Moldudley/Maslow-Mini-Control-Board/Merged Control Board/Maslow Mini Merged Board.kicad_pcb

## KiCad design Merged Control Board/Maslow Mini Merged Board.kicad_pcb (2026-09-01)

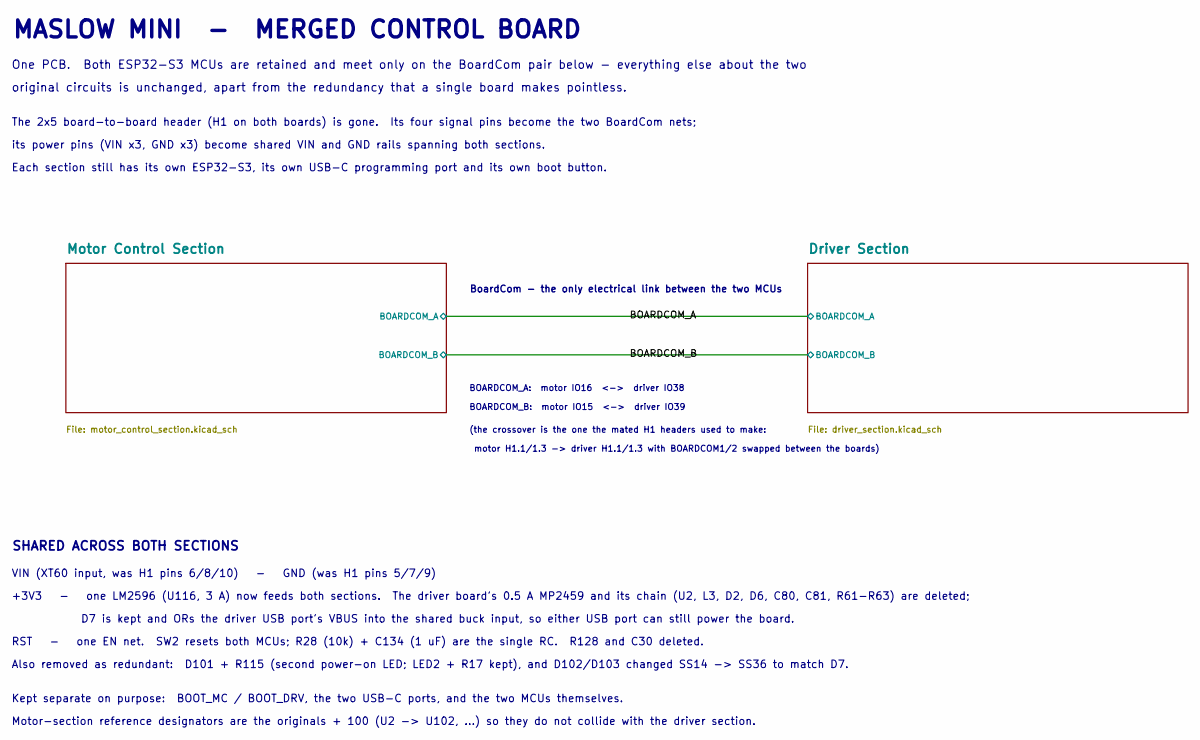
[picture p1: schematic Maslow Mini Merged Board.kicad_sch, Maslow Mini Merged Control Board]

Notes on the sheet:
MASLOW MINI - MERGED CONTROL BOARD
One PCB. Both ESP32-S3 MCUs are retained and meet only on the BoardCom pair below - everything else about the two
original circuits is unchanged, apart from the redundancy that a single board makes pointless.
The 2x5 board-to-board header (H1 on both boards) is gone. Its four signal pins become the two BoardCom nets;
its power pins (VIN x3, GND x3) become shared VIN and GND rails spanning both sections.
Each section still has its own ESP32-S3, its own USB-C programming port and its own boot button.
BoardCom - the only electrical link between the two MCUs
BOARDCOM_A: motor IO16 <-> driver IO38
BOARDCOM_B: motor IO15 <-> driver IO39
(the crossover is the one the mated H1 headers used to make:
motor H1.1/1.3 -> driver H1.1/1.3 with BOARDCOM1/2 swapped between the boards)
SHARED ACROSS BOTH SECTIONS
VIN (XT60 input, was H1 pins 6/8/10) - GND (was H1 pins 5/7/9)
+3V3 - one LM2596 (U116, 3 A) now feeds both sections. The driver board's 0.5 A MP2459 and its chain (U2, L3, D2, D6, C80, C81, R61-R63) are deleted;
D7 is kept and ORs the driver USB port's VBUS into the shared buck input, so either USB port can still power the board.
RST - one EN net. SW2 resets both MCUs; R28 (10k) + C134 (1 uF) are the single RC. R128 and C30 deleted.
Also removed as redundant: D101 + R115 (second power-on LED; LED2 + R17 kept), and D102/D103 changed SS14 -> SS36 to match D7.
Kept separate on purpose: BOOT_MC / BOOT_DRV, the two USB-C ports, and the two MCUs themselves.
Motor-section reference designators are the originals + 100 (U2 -> U102, ...) so they do not collide with the driver section.

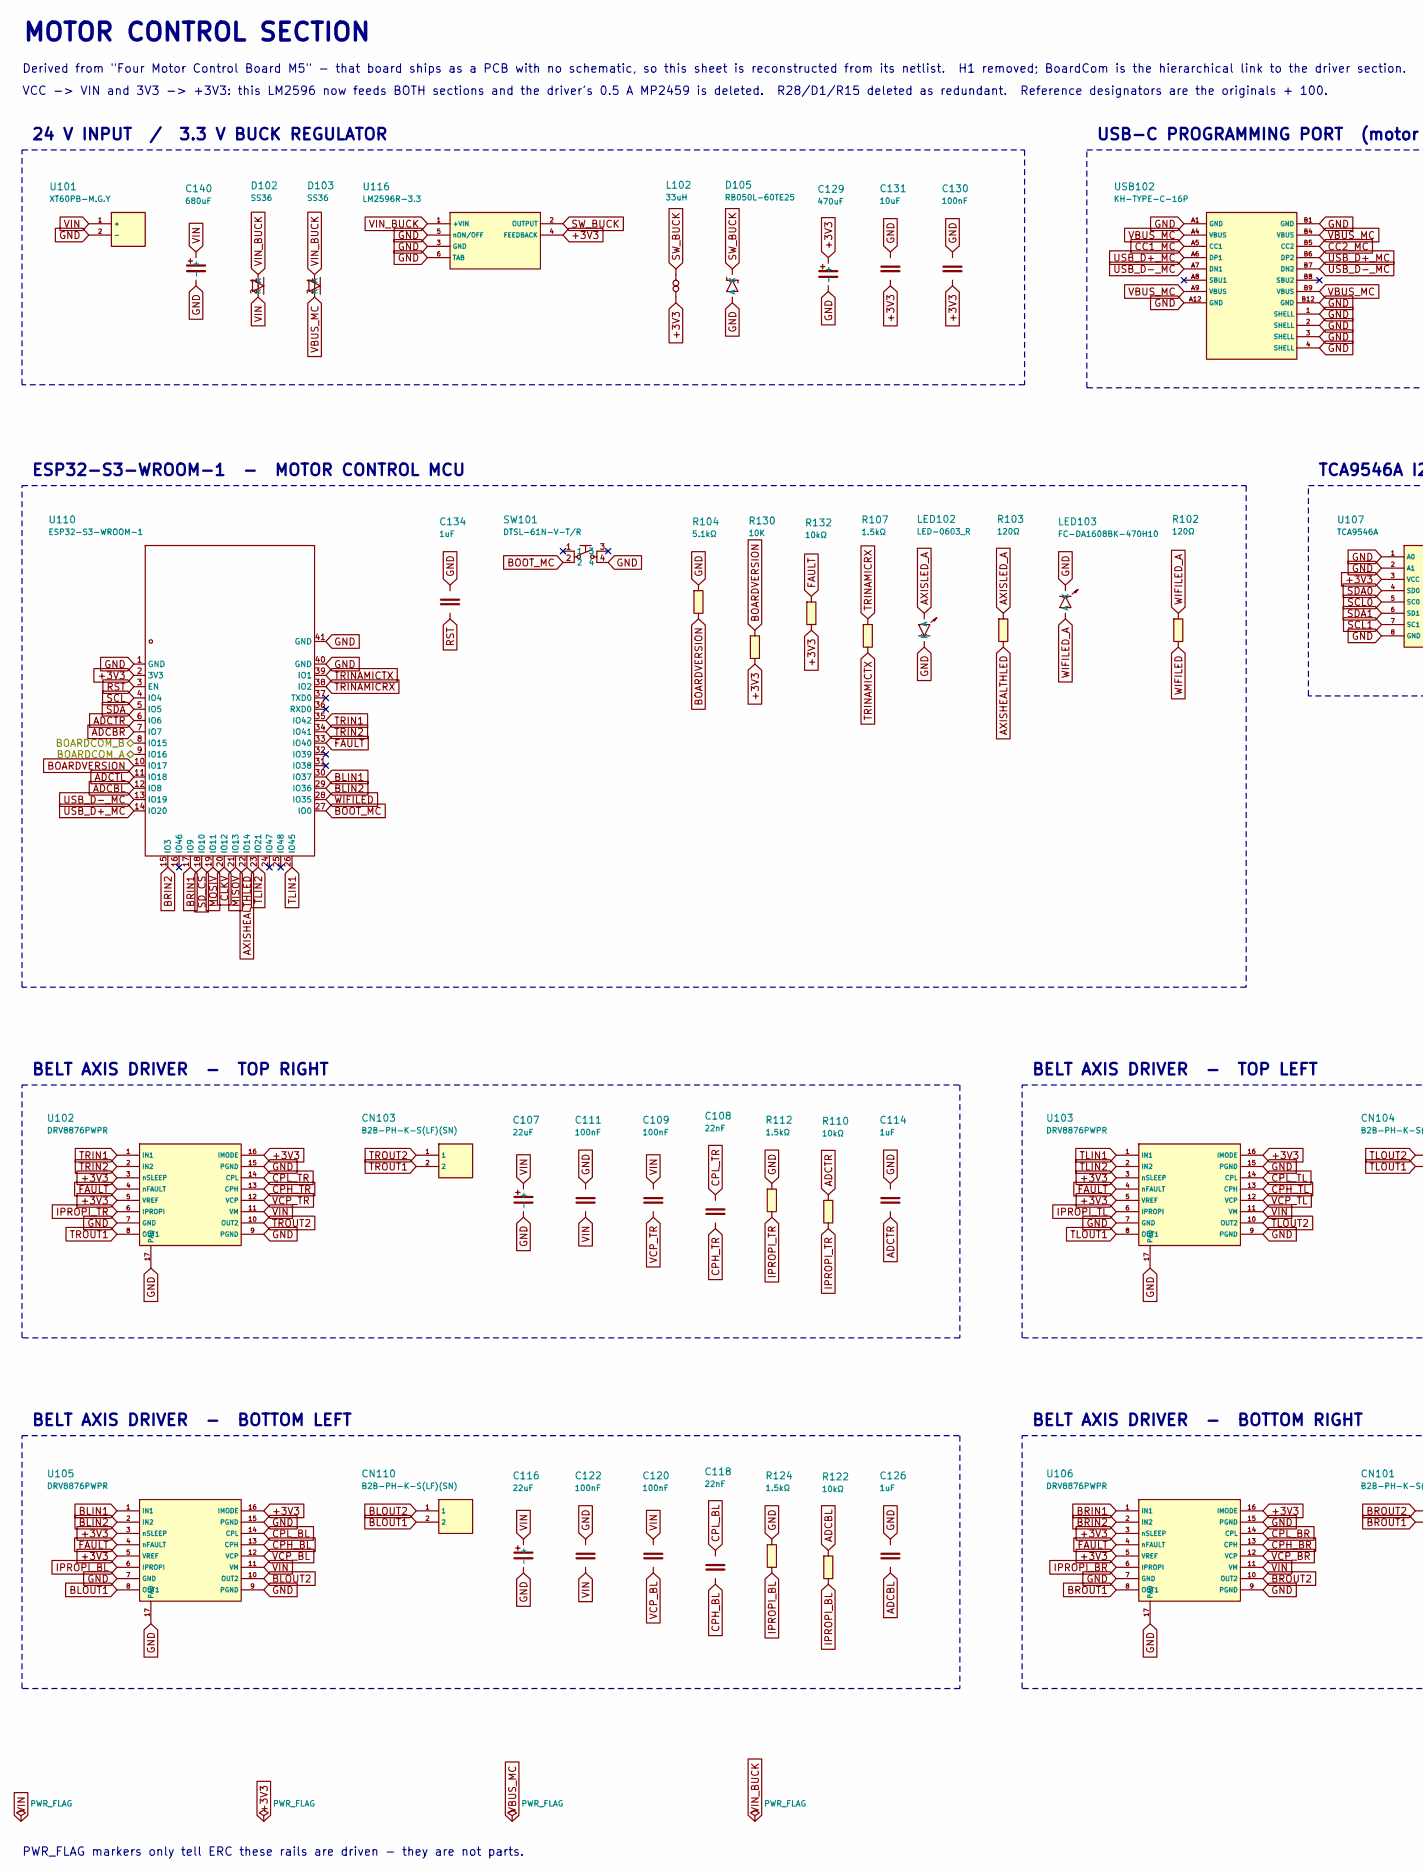
[picture p2: schematic motor_control_section.kicad_sch, part in row 1, column 1]

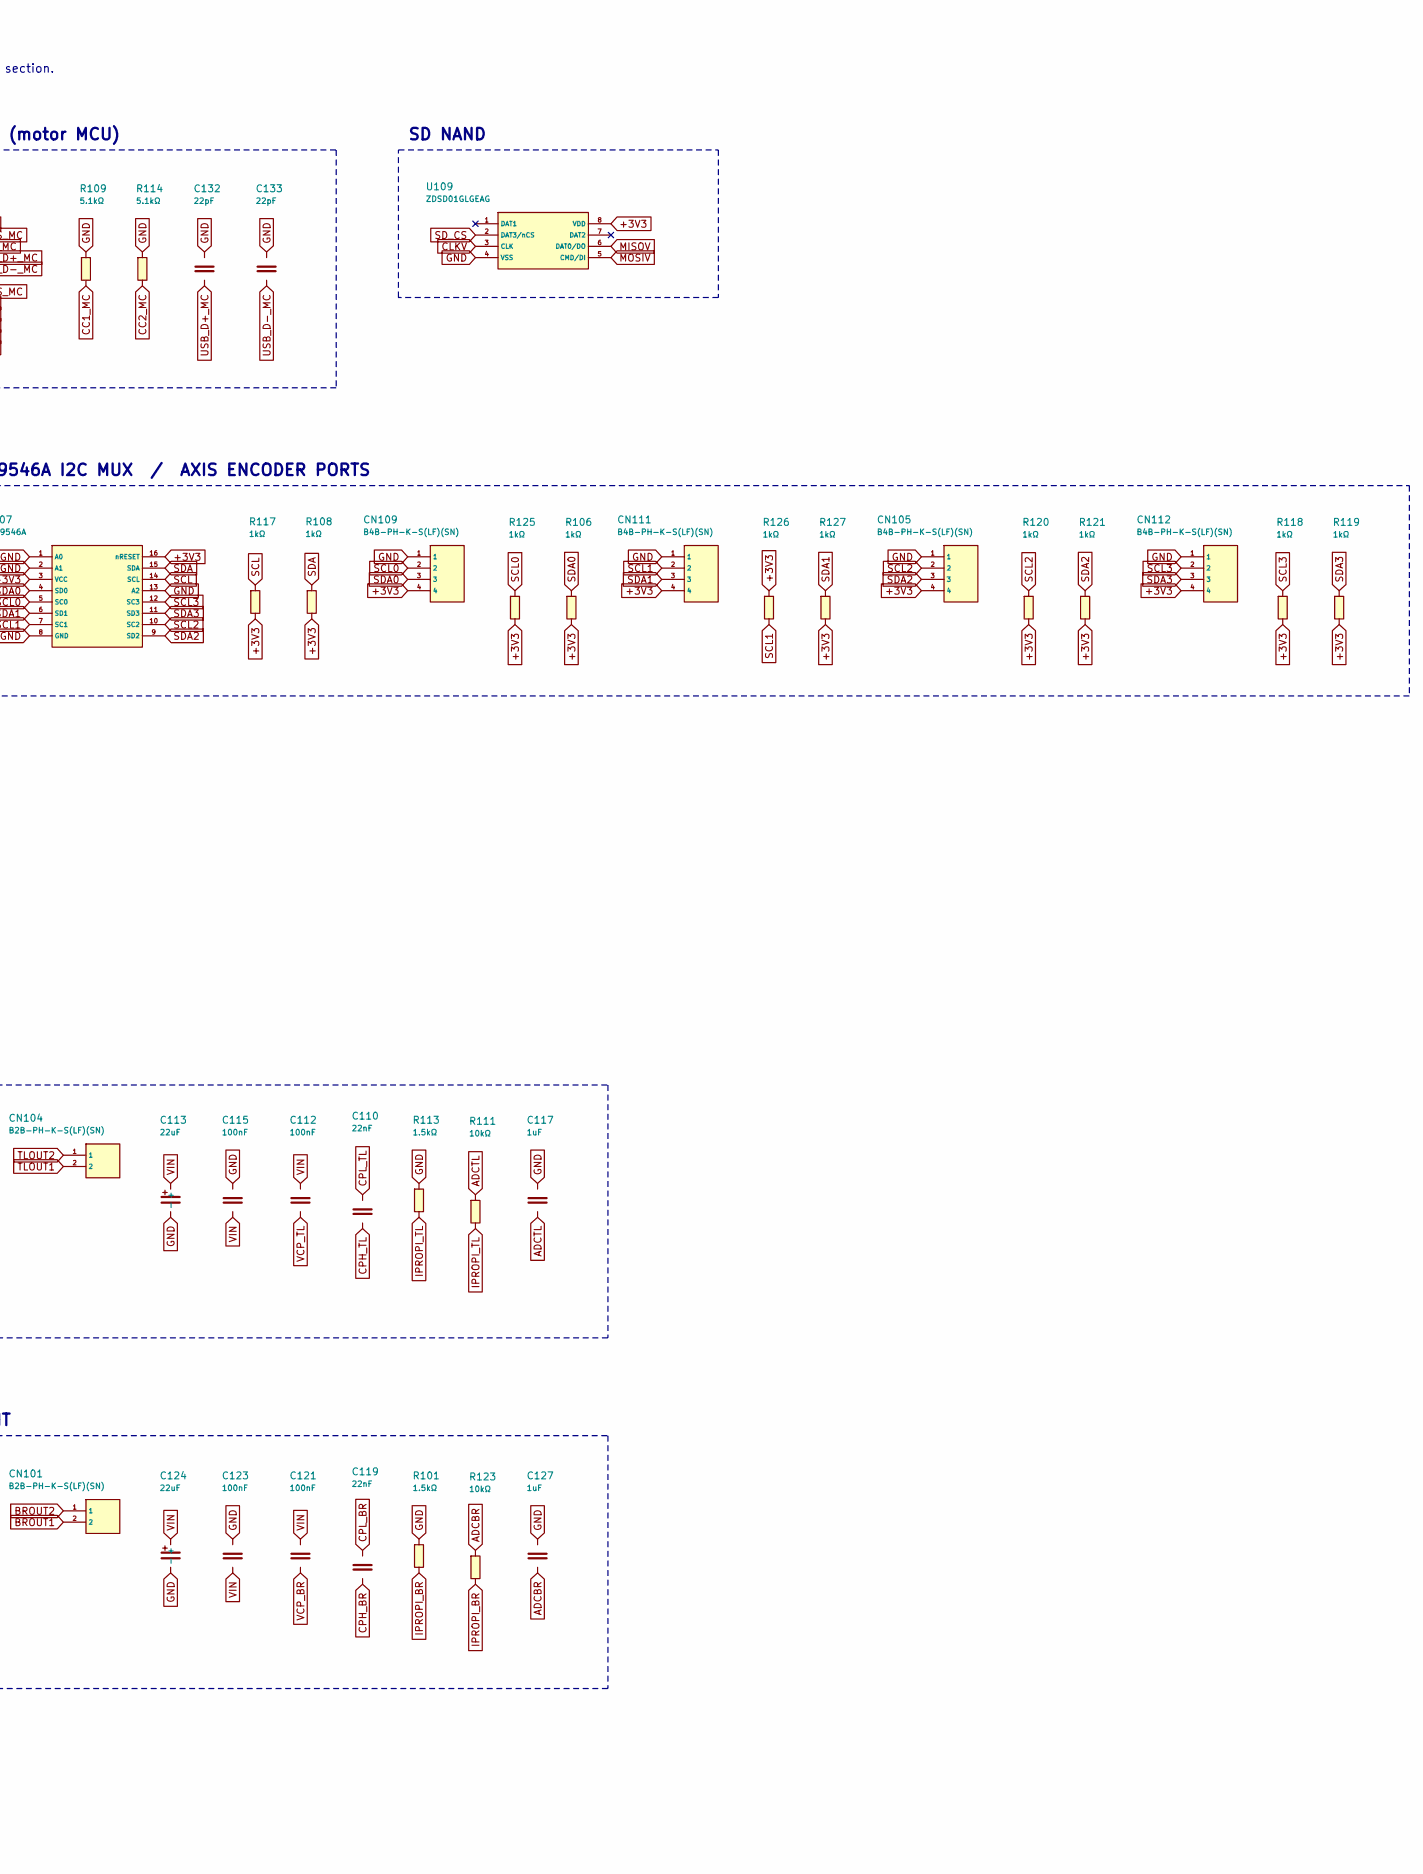
[picture p3: schematic motor_control_section.kicad_sch, part in row 1, column 2]

Parts:
C107, C113, C116, C124: 22uF; CAP-SMD_BD6.3-L6.6-W6.6-LS7.3-FD
C108, C110, C118, C119: 22nF; C0805
C109, C111, C112, C115, C120, C121, C122, C123: 100nF; C0805
C114, C117, C126, C127: 1uF; C0805
C129: 470uF; CAP-SMD_BD6.3-L6.6-W6.6-LS7.6-RD
C130: 100nF; C0603
C131: 10uF; C0805
C132, C133: 22pF; C0603
C134: 1uF; C0603
C140: 680uF; CAP-SMD_BD10.0-L10.3-W10.3-LS10.9-FD
CN101, CN103, CN104, CN110: B2B-PH-K-S(LF)(SN); CONN-TH_B2B-PH-K-S
CN105, CN109, CN111, CN112: B4B-PH-K-S(LF)(SN); CONN-TH_B4B-PH-K-S
D102, D103: SS36; D_SMA
D105: RB050L-60TE25; SMA_L4.3-W2.7-LS5.1-RD
L102: 33uH; IND-SMD_L6.0-W6.0
LED102: LED-0603_R; LED0603_RED
LED103: FC-DA1608BK-470H10; LED0603-RD
R101, R107, R112, R113, R124: 1.5kΩ; R0805
R102, R103: 120Ω; R0603
R104, R109, R114: 5.1kΩ; R0805
R106, R108, R117, R118, R119, R120, R121, R125, R126, R127: 1kΩ; R0402
R110, R111, R122, R123, R132: 10kΩ; R0805
R130: 10K; R0603
SW101: DTSL-61N-V-T/R; SW-SMD_4P-L6.2-W6.4-P4.00-LS7.2
U101: XT60PB-M.G.Y; CONN-TH_XT60PB-M
U102, U103, U105, U106: DRV8876PWPR; HTSSOP-16_L5.0-W4.4-P0.65-LS6.4-BL-EP
U107: TCA9546A; SOP-16_L5.0-W4.4-P0.65-LS6.4-BL
U109: ZDSD01GLGEAG; LGA-8_L6.0-W8.0-P1.27-BL
U110: ESP32-S3-WROOM-1; WIRELM-SMD_ESP32-S3-WROOM-1
U116: LM2596R-3.3; TO-263-5_L10.2-W8.6-P1.70-LS14.4-TL
USB102: KH-TYPE-C-16P; USB-C-SMD_KH-TYPE-C-16P

Connections:
+3V3: C129.1 (+), C130.2, C131.2, CN105.4, CN109.4, CN111.4, CN112.4, L102.2, R106.2, R108.2, R117.2, R118.2, R119.2, R120.2, R121.2, R125.2, R126.1, R127.2, R130.2, R132.2, U102.3 (nSLEEP), U102.5 (VREF), U102.16 (IMODE), U103.3 (nSLEEP), U103.5 (VREF), U103.16 (IMODE), U105.3 (nSLEEP), U105.5 (VREF), U105.16 (IMODE), U106.3 (nSLEEP), U106.5 (VREF), U106.16 (IMODE), U107.3 (VCC), U107.16 (nRESET), U109.8 (VDD), U110.2 (3V3), U116.4 (FEEDBACK); also elsewhere on the board
/BOARDCOM_A: U110.9 (IO16); also elsewhere on the board
/BOARDCOM_B: U110.8 (IO15); also elsewhere on the board
ADCBL: C126.2, R122.1, U110.12 (IO8)
ADCBR: C127.2, R123.1, U110.7 (IO7)
ADCTL: C117.2, R111.1, U110.11 (IO18)
ADCTR: C114.2, R110.1, U110.6 (IO6)
AXISHEALTHLED: R103.2, U110.22 (IO14)
AXISLED_A: LED102.1 (A), R103.1
BLIN1: U105.1 (IN1), U110.30 (IO37)
BLIN2: U105.2 (IN2), U110.29 (IO36)
BLOUT1: CN110.2, U105.8 (OUT1)
BLOUT2: CN110.1, U105.10 (OUT2)
BOARDVERSION: R104.2, R130.1, U110.10 (IO17)
BOOT_MC: SW101.2, U110.27 (IO0)
BRIN1: U106.1 (IN1), U110.17 (IO9)
BRIN2: U106.2 (IN2), U110.15 (IO3)
BROUT1: CN101.2, U106.8 (OUT1)
BROUT2: CN101.1, U106.10 (OUT2)
CC1_MC: R109.2, USB102.A5 (CC1)
CC2_MC: R114.2, USB102.B5 (CC2)
CLKV: U109.3 (CLK), U110.20 (IO12)
CPH_BL: C118.2, U105.13 (CPH)
CPH_BR: C119.2, U106.13 (CPH)
CPH_TL: C110.2, U103.13 (CPH)
CPH_TR: C108.2, U102.13 (CPH)
CPL_BL: C118.1, U105.14 (CPL)
CPL_BR: C119.1, U106.14 (CPL)
CPL_TL: C110.1, U103.14 (CPL)
CPL_TR: C108.1, U102.14 (CPL)
FAULT: R132.1, U102.4 (nFAULT), U103.4 (nFAULT), U105.4 (nFAULT), U106.4 (nFAULT), U110.33 (IO40)
GND: C107.2 (-), C111.1, C113.2 (-), C114.1, C115.1, C116.2 (-), C117.1, C122.1, C123.1, C124.2 (-), C126.1, C127.1, C129.2 (-), C130.1, C131.1, C132.1, C133.1, C134.1, C140.2 (-), CN105.1, CN109.1, CN111.1, CN112.1, D105.2 (A), LED102.2 (K), LED103.1 (K), R101.1, R104.1, R109.1, R112.1, R113.1, R114.1, R124.1, SW101.4, U101.2 (-), U102.7 (GND), U102.9 (PGND), U102.15 (PGND), U102.17 (PAD), U103.7 (GND), U103.9 (PGND), U103.15 (PGND), U103.17 (PAD), U105.7 (GND), U105.9 (PGND), U105.15 (PGND), U105.17 (PAD), U106.7 (GND), U106.9 (PGND), U106.15 (PGND), U106.17 (PAD), U107.1 (A0), U107.2 (A1), U107.8 (GND), U107.13 (A2), U109.4 (VSS), U110.1 (GND), U110.40 (GND), U110.41 (GND), U116.3 (GND), U116.5 (nON/OFF), U116.6 (TAB), USB102.1 (SHELL), USB102.2 (SHELL), USB102.3 (SHELL), USB102.4 (SHELL), USB102.A1 (GND), USB102.A12 (GND), USB102.B1 (GND), USB102.B12 (GND); also elsewhere on the board
IPROPI_BL: R122.2, R124.2, U105.6 (IPROPI)
IPROPI_BR: R101.2, R123.2, U106.6 (IPROPI)
IPROPI_TL: R111.2, R113.2, U103.6 (IPROPI)
IPROPI_TR: R110.2, R112.2, U102.6 (IPROPI)
MISOV: U109.6 (DAT0/DO), U110.21 (IO13)
MOSIV: U109.5 (CMD/DI), U110.19 (IO11)
RST: C134.2, U110.3 (EN); also elsewhere on the board
SCL: R117.1, U107.14 (SCL), U110.4 (IO4)
SCL0: CN109.2, R125.1, U107.5 (SC0)
SCL1: CN111.2, R126.2, U107.7 (SC1)
SCL2: CN105.2, R120.1, U107.10 (SC2)
SCL3: CN112.2, R118.1, U107.12 (SC3)
SDA: R108.1, U107.15 (SDA), U110.5 (IO5)
SDA0: CN109.3, R106.1, U107.4 (SD0)
SDA1: CN111.3, R127.1, U107.6 (SD1)
SDA2: CN105.3, R121.1, U107.9 (SD2)
SDA3: CN112.3, R119.1, U107.11 (SD3)
SD_CS: U109.2 (DAT3/nCS), U110.18 (IO10)
SW_BUCK: D105.1 (K), L102.1, U116.2 (OUTPUT)
TLIN1: U103.1 (IN1), U110.26 (IO45)
TLIN2: U103.2 (IN2), U110.23 (IO21)
TLOUT1: CN104.2, U103.8 (OUT1)
TLOUT2: CN104.1, U103.10 (OUT2)
TRIN1: U102.1 (IN1), U110.35 (IO42)
TRIN2: U102.2 (IN2), U110.34 (IO41)
TRINAMICRX: R107.1, U110.38 (IO2)
TRINAMICTX: R107.2, U110.39 (IO1)
TROUT1: CN103.2, U102.8 (OUT1)
TROUT2: CN103.1, U102.10 (OUT2)
USB_D+_MC: C132.2, U110.14 (IO20), USB102.A6 (DP1), USB102.B6 (DP2)
USB_D-_MC: C133.2, U110.13 (IO19), USB102.A7 (DN1), USB102.B7 (DN2)
VBUS_MC: D103.2 (A), USB102.A4 (VBUS), USB102.A9 (VBUS), USB102.B4 (VBUS), USB102.B9 (VBUS)
VCP_BL: C120.2, U105.12 (VCP)
VCP_BR: C121.2, U106.12 (VCP)
VCP_TL: C112.2, U103.12 (VCP)
VCP_TR: C109.2, U102.12 (VCP)
VIN: C107.1 (+), C109.1, C111.2, C112.1, C113.1 (+), C115.2, C116.1 (+), C120.1, C121.1, C122.2, C123.2, C124.1 (+), C140.1 (+), D102.2 (A), U101.1 (+), U102.11 (VM), U103.11 (VM), U105.11 (VM), U106.11 (VM); also elsewhere on the board
VIN_BUCK: D102.1 (K), D103.1 (K), U116.1 (+VIN); also elsewhere on the board
WIFILED: R102.2, U110.28 (IO35)
WIFILED_A: LED103.2 (A), R102.1

Notes on the sheet:
MOTOR CONTROL SECTION
Derived from "Four Motor Control Board M5" - that board ships as a PCB with no schematic, so this sheet is reconstructed from its netlist. H1 removed; BoardCom is the hierarchical link to the driver section.
VCC -> VIN and 3V3 -> +3V3: this LM2596 now feeds BOTH sections and the driver's 0.5 A MP2459 is deleted. R28/D1/R15 deleted as redundant. Reference designators are the originals + 100.
24 V INPUT / 3.3 V BUCK REGULATOR
USB-C PROGRAMMING PORT (motor MCU)
SD NAND
ESP32-S3-WROOM-1 - MOTOR CONTROL MCU
TCA9546A I2C MUX / AXIS ENCODER PORTS
BELT AXIS DRIVER - TOP RIGHT
BELT AXIS DRIVER - TOP LEFT
BELT AXIS DRIVER - BOTTOM LEFT
BELT AXIS DRIVER - BOTTOM RIGHT
PWR_FLAG markers only tell ERC these rails are driven - they are not parts.

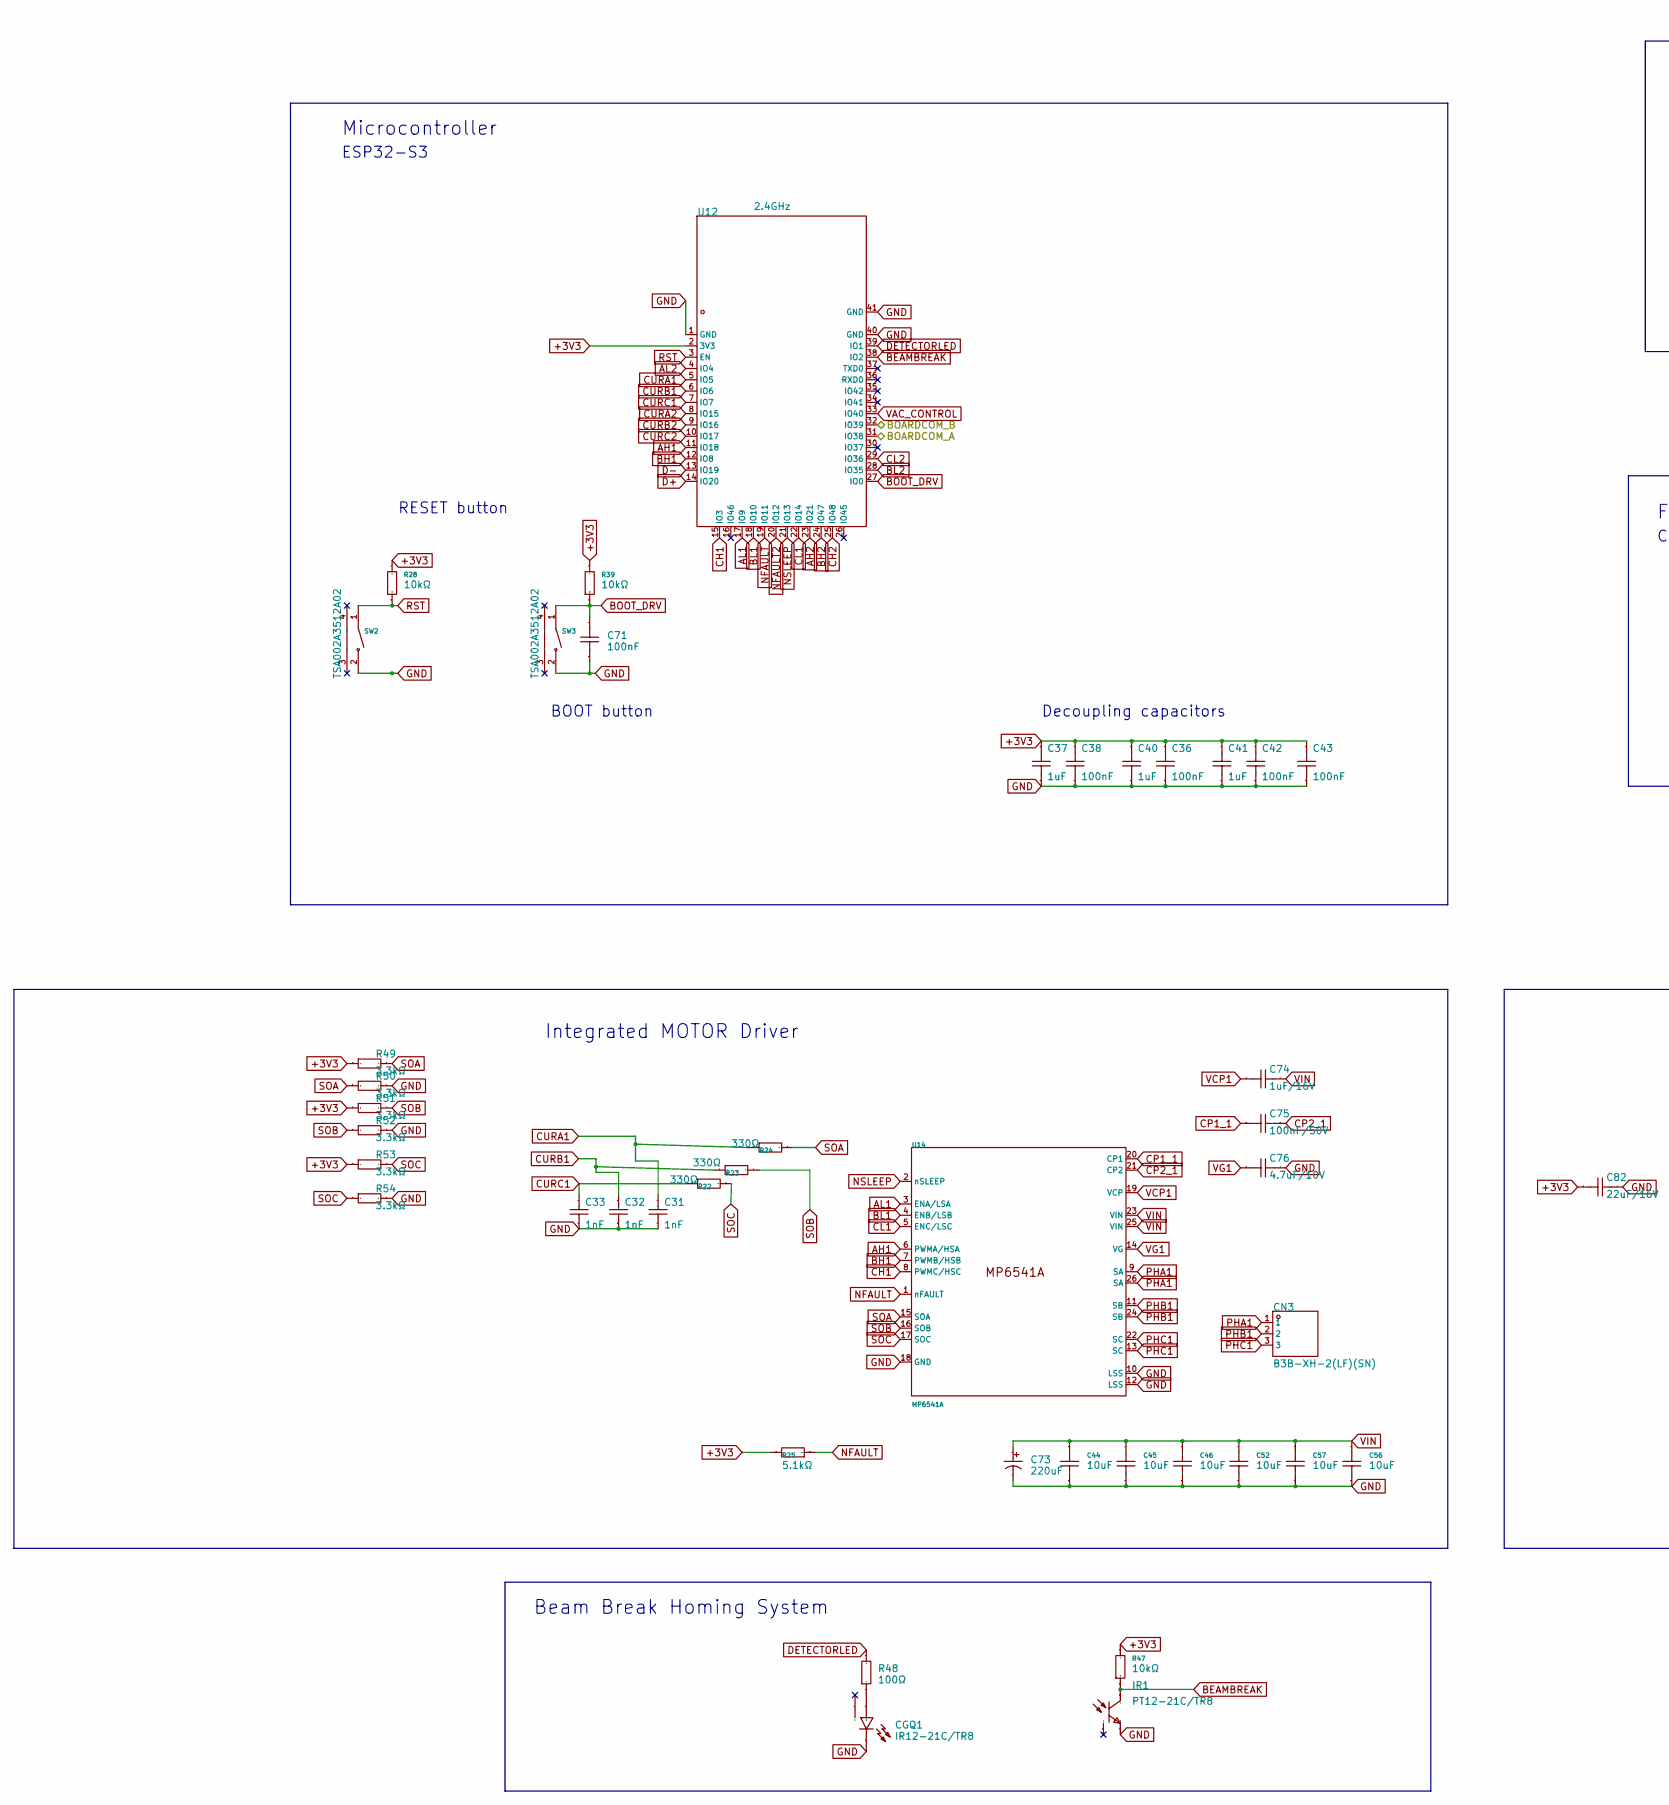
[picture p4: schematic driver_section.kicad_sch, part in row 1, column 1]

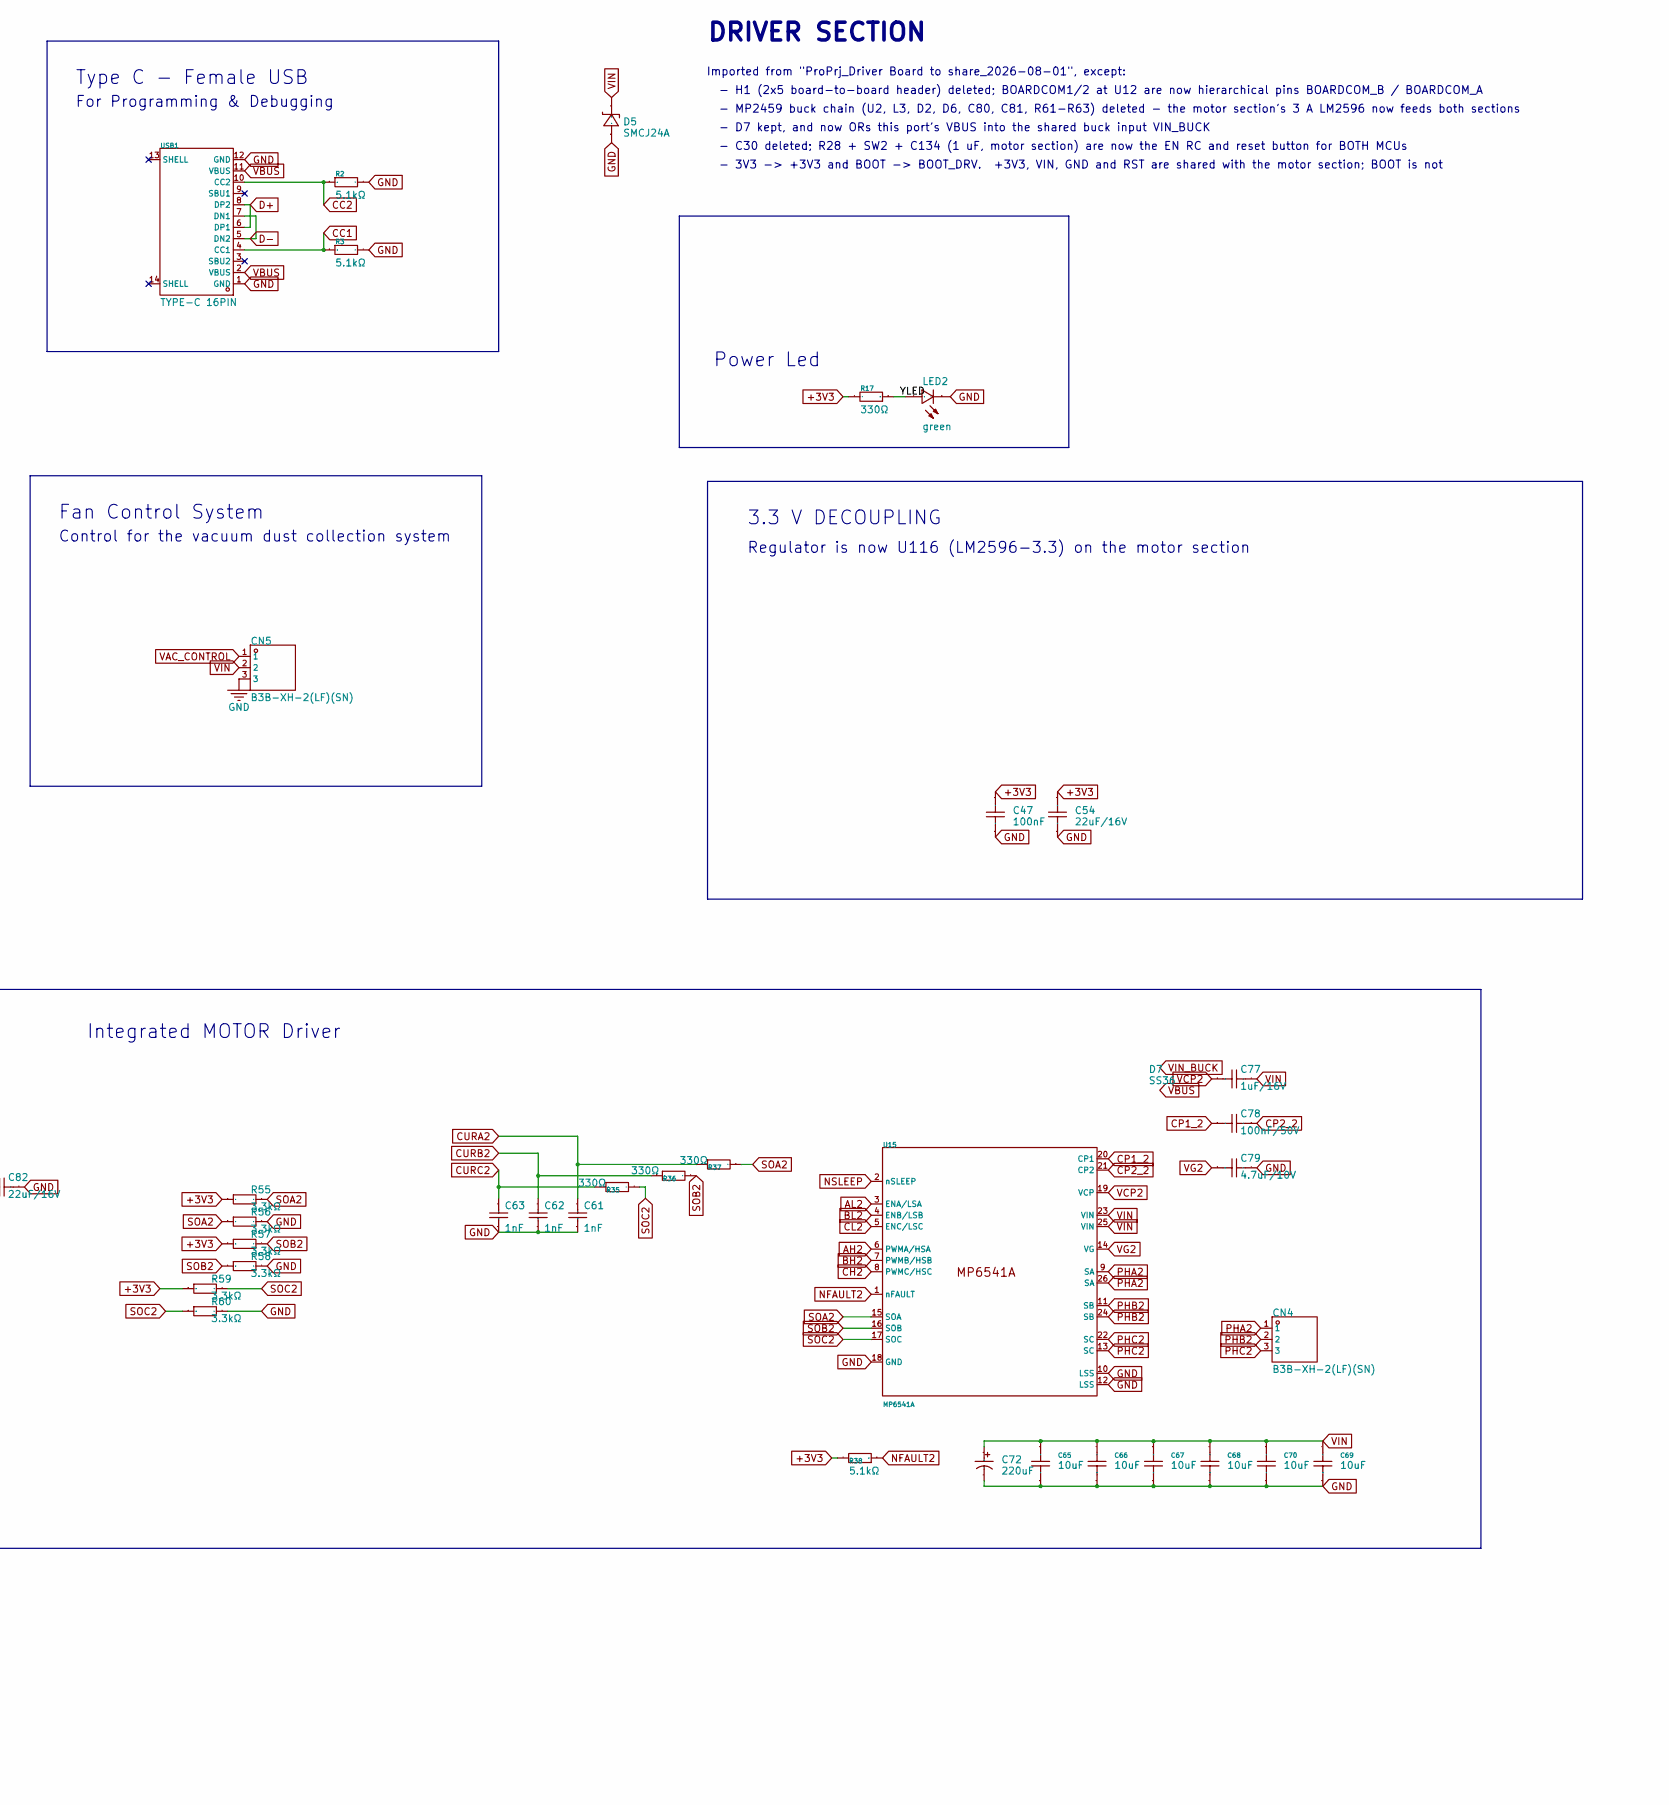
[picture p5: schematic driver_section.kicad_sch, part in row 1, column 2]

Parts:
C31, C32, C33, C61, C62, C63: 1nF; C0402; Manufacturer Part CL05B102KB5NNNC; LCSC Part Name 1nF ±10% 50V X7R 0402 MLCC
C36, C38, C42, C43, C47, C71: 100nF; C0402; Manufacturer Part CL05B104KB54PNC; LCSC Part Name 100nF ±10% 50V
C37, C40, C41: 1uF; C0402; Manufacturer Part CL05A105KA5NQNC; LCSC Part Name 1uF ±10% 25V
C44, C45, C46, C52, C56, C57, C65, C66, C67, C68, C69, C70: 10uF; C0805; Manufacturer Part GRM21BR61H106KE43L; LCSC Part Name 10uF ±10% 50V
C54: 22uF/16V; C0805; Manufacturer Part GRM219R61C226ME15L; LCSC Part Name 22uF ±20% 16V X5R 0805 MLCC
C72, C73: 220uF; CAP-TH_BD8.0-P3.50-D0.6-FD; Manufacturer Part ERS1VM221F12OT; LCSC Part Name 220uF ±20% 35V
C74, C77: 1uF/16V; C0603; Manufacturer Part CL10B105KO8NNNC; LCSC Part Name 1µF ±10% 16V X7R 0603 MLCC
C75, C78: 100nF/50V; C0603; Manufacturer Part CL10B104KB8NNNC; LCSC Part Name 100nF ±10% 50V X7R 0603 MLCC
C76, C79: 4.7uF/10V; C0805; Manufacturer Part EMK212B7475KG-T; LCSC Part Name 4.7µF ±10% 16V X7R 0805 MLCC
C82: 22uF/16V; C0805; Manufacturer Part GRM219R61C226ME15L; LCSC Part Name 22µF ±20% 16V X5R 0805 MLCC
CGQ1: IR12-21C/TR8; LED-SMD_IR12-21C-TR8; Manufacturer Part IR12-21C/TR8; LCSC Part Name 65mA红外发射管
CN3, CN4, CN5: B3B-XH-2(LF)(SN); CONN-TH_B3B-XH-2-LF-SN; Manufacturer Part B3B-XH-2(LF)(SN); LCSC Part Name 1x3P 间距:2.5mm 直插 系列:XH
D5: SMCJ24A; SMC_L7.1-W6.2-LS8.1-R-RD; Manufacturer Part SMCJ24A; LCSC Part Name SMCJ24A
D7: SS36; D_SMA; Manufacturer Part SS36; LCSC Part Name SS36 60V 3A Schottky Diode SMA
IR1: PT12-21C/TR8; SENSOR-SMD_L3.0-W2.0-RD; Manufacturer Part PT12-21C/TR8; LCSC Part Name 940nm的NPN光电三极管
LED2: green; LED0603-RD-YELLOW; Manufacturer Part KT-0603YG; LCSC Part Name Green 570nm 0603 LED, Vf 2.0-2.2V, 30-4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
R2, R3, R25, R38: 5.1kΩ; R0402; Manufacturer Part 0402WGF5101TCE; LCSC Part Name 5.1kΩ ±1% 62.5mW 厚膜电阻
R17: 330Ω; R0402; Manufacturer Part 0402WGF3300TCE; LCSC Part Name 330Ω ±1% 1/16W 0402 Chip Resistor
R22, R23, R24, R35, R36, R37: 330Ω; R0402; Manufacturer Part 0402WGF3300TCE; LCSC Part Name 330Ω ±1% 62.5mW 厚膜电阻
R28, R39, R47: 10kΩ; R0402; Manufacturer Part 0402WGF1002TCE; LCSC Part Name 10kΩ ±1% 62.5mW 厚膜电阻
R48: 100Ω; R0402; Manufacturer Part 0402WGF1000TCE; LCSC Part Name 100Ω ±1% 1/16W 0402 Chip Resistor
R49, R50, R51, R52, R53, R54, R55, R56, R57, R58, R59, R60: 3.3kΩ; R0402; Manufacturer Part RC0402FR-073K3L; LCSC Part Name 3.3kΩ ±1% 1/16W 0402 Chip Resistor
SW2, SW3: TSA002A3512A02; SW-SMD_BZCN_TSA002A35XXX; Manufacturer Part TSA002A3512A02; LCSC Part Name 4.8*2*3.5mm 卧贴 轻触开关
U12: 2.4GHz; WIRELM-SMD_ESP32-S3-WROOM-1; Manufacturer Part ESP32-S3-WROOM-1-N8R2; LCSC Part Name 通用型Wi-Fi+低功耗蓝牙MCU模组
U14, U15: MP6541A; TQFN-26 (6X6MM); Manufacturer Part MP6541A
USB1: TYPE-C 16PIN; USB-C-SMD_TYPE-C-6PIN-2MD-073; Manufacturer Part TYPE-C 16PIN; LCSC Part Name Type-C 母 卧贴

Connections:
+3V3: C36.2, C37.2, C38.2, C40.2, C41.2, C42.2, C43.2, C47.2, C54.2, C82.1, R17.2, R25.2, R28.2, R38.2, R39.2, R47.2, R49.1, R51.1, R53.1, R55.1, R57.1, R59.1, U12.2 (3V3); also elsewhere on the board
/BOARDCOM_A: U12.31 (IO38); also elsewhere on the board
/BOARDCOM_B: U12.32 (IO39); also elsewhere on the board
/Driver Section/YLED: LED2.2 (A), R17.1
AH1: U12.11 (IO18), U14.6 (PWMA/HSA)
AH2: U12.23 (IO21), U15.6 (PWMA/HSA)
AL1: U12.17 (IO9), U14.3 (ENA/LSA)
AL2: U12.4 (IO4), U15.3 (ENA/LSA)
BEAMBREAK: IR1.1 (C), R47.1, U12.38 (IO2)
BH1: U12.12 (IO8), U14.7 (PWMB/HSB)
BH2: U12.24 (IO47), U15.7 (PWMB/HSB)
BL1: U12.18 (IO10), U14.4 (ENB/LSB)
BL2: U12.28 (IO35), U15.4 (ENB/LSB)
BOOT_DRV: C71.2, R39.1, SW3.1, U12.27 (IO0)
CC1: R3.1, USB1.4 (CC1)
CC2: R2.1, USB1.10 (CC2)
CH1: U12.15 (IO3), U14.8 (PWMC/HSC)
CH2: U12.25 (IO48), U15.8 (PWMC/HSC)
CL1: U12.22 (IO14), U14.5 (ENC/LSC)
CL2: U12.29 (IO36), U15.5 (ENC/LSC)
CP1_1: C75.1, U14.20 (CP1)
CP1_2: C78.1, U15.20 (CP1)
CP2_1: C75.2, U14.21 (CP2)
CP2_2: C78.2, U15.21 (CP2)
CURA1: C31.2, R24.1, U12.5 (IO5)
CURA2: C61.2, R37.1, U12.8 (IO15)
CURB1: C32.2, R23.1, U12.6 (IO6)
CURB2: C62.2, R36.1, U12.9 (IO16)
CURC1: C33.2, R22.1, U12.7 (IO7)
CURC2: C63.2, R35.1, U12.10 (IO17)
D+: U12.14 (IO20), USB1.6 (DP1), USB1.8 (DP2)
D-: U12.13 (IO19), USB1.5 (DN2), USB1.7 (DN1)
DETECTORLED: R48.2, U12.39 (IO1)
GND: C31.1, C32.1, C33.1, C36.1, C37.1, C38.1, C40.1, C41.1, C42.1, C43.1, C44.1, C45.1, C46.1, C47.1, C52.1, C54.1, C56.1, C57.1, C61.1, C62.1, C63.1, C65.1, C66.1, C67.1, C68.1, C69.1, C70.1, C71.1, C72.2, C73.2, C76.2, C79.2, C82.2, CGQ1.1 (C), CN5.3, D5.1 (A), IR1.2 (E), LED2.1 (C), R2.2, R3.2, R50.2, R52.2, R54.2, R56.2, R58.2, R60.2, SW2.2, SW3.2, U12.1 (GND), U12.40 (GND), U12.41 (GND), U14.10 (LSS), U14.12 (LSS), U14.18 (GND), U15.10 (LSS), U15.12 (LSS), U15.18 (GND), USB1.1 (GND), USB1.12 (GND); also elsewhere on the board
NFAULT: R25.1, U12.19 (IO11), U14.1 (nFAULT)
NFAULT2: R38.1, U12.20 (IO12), U15.1 (nFAULT)
NSLEEP: U12.21 (IO13), U14.2 (nSLEEP), U15.2 (nSLEEP)
unnamed: CGQ1.2 (A), R48.1
PHA1: CN3.1, U14.9 (SA), U14.26 (SA)
PHA2: CN4.1, U15.9 (SA), U15.26 (SA)
PHB1: CN3.2, U14.11 (SB), U14.24 (SB)
PHB2: CN4.2, U15.11 (SB), U15.24 (SB)
PHC1: CN3.3, U14.13 (SC), U14.22 (SC)
PHC2: CN4.3, U15.13 (SC), U15.22 (SC)
RST: R28.1, SW2.1, U12.3 (EN); also elsewhere on the board
SOA: R24.2, R49.2, R50.1, U14.15 (SOA)
SOA2: R37.2, R55.2, R56.1, U15.15 (SOA)
SOB: R23.2, R51.2, R52.1, U14.16 (SOB)
SOB2: R36.2, R57.2, R58.1, U15.16 (SOB)
SOC: R22.2, R53.2, R54.1, U14.17 (SOC)
SOC2: R35.2, R59.2, R60.1, U15.17 (SOC)
VAC_CONTROL: CN5.1, U12.33 (IO40)
VBUS: D7.2 (A), USB1.2 (VBUS), USB1.11 (VBUS)
VCP1: C74.1, U14.19 (VCP)
VCP2: C77.1, U15.19 (VCP)
VG1: C76.1, U14.14 (VG)
VG2: C79.1, U15.14 (VG)
VIN: C44.2, C45.2, C46.2, C52.2, C56.2, C57.2, C65.2, C66.2, C67.2, C68.2, C69.2, C70.2, C72.1, C73.1, C74.2, C77.2, CN5.2, D5.2 (K), U14.23 (VIN), U14.25 (VIN), U15.23 (VIN), U15.25 (VIN); also elsewhere on the board
VIN_BUCK: D7.1 (K); also elsewhere on the board

Notes on the sheet:
Decoupling capacitors
Microcontroller
Regulator is now U116 (LM2596-3.3) on the motor section
Control for the vacuum dust collection system
Integrated MOTOR Driver
ESP32-S3
BOOT button
Power Led
3.3 V DECOUPLING
RESET button
For Programming & Debugging
Type C - Female USB
Beam Break Homing System
Fan Control System
DRIVER SECTION
Imported from "ProPrj_Driver Board to share_2026-08-01", except:
- H1 (2x5 board-to-board header) deleted; BOARDCOM1/2 at U12 are now hierarchical pins BOARDCOM_B / BOARDCOM_A
- MP2459 buck chain (U2, L3, D2, D6, C80, C81, R61-R63) deleted - the motor section's 3 A LM2596 now feeds both sections
- D7 kept, and now ORs this port's VBUS into the shared buck input VIN_BUCK
- C30 deleted; R28 + SW2 + C134 (1 uF, motor section) are now the EN RC and reset button for BOTH MCUs
- 3V3 -> +3V3 and BOOT -> BOOT_DRV. +3V3, VIN, GND and RST are shared with the motor section; BOOT is not

Board: 4 copper layers, 156 parts (104 on the bottom side), 124 nets, no tracks yet.
