Moldudley/Maslow-Mini-Control-Board/Motor Controller Board/Four Motor Control Board M5_fbc631ad57bc4ffbb8f9b332692f9e33.kicad_pcb

## KiCad design Motor Controller Board/Four Motor Control Board M5_fbc631ad57bc4ffbb8f9b332692f9e33.kicad_pcb (2026-09-01)

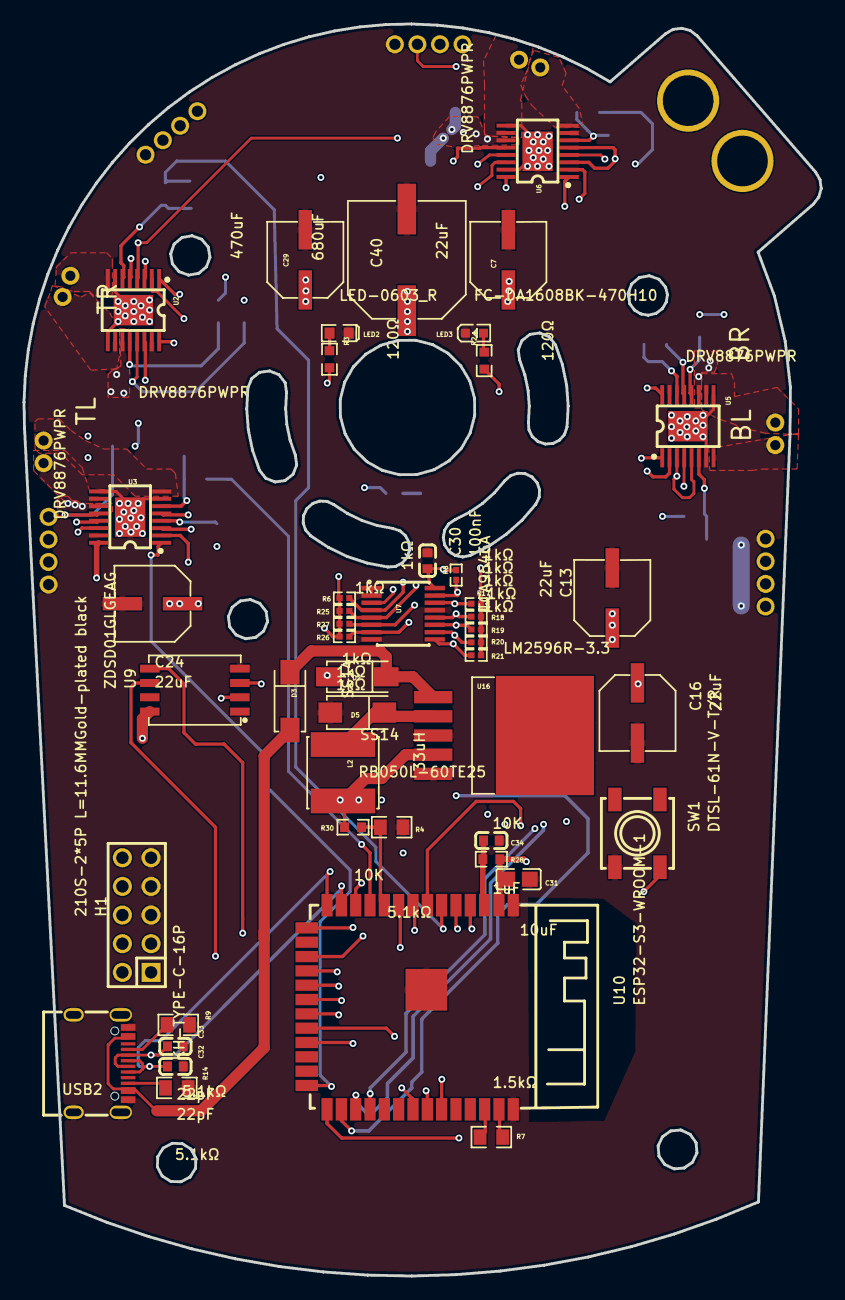
[picture p6: board Four Motor Control Board M5_fbc631ad57bc4ffbb8f9b332692f9e33.kicad_pcb from above]

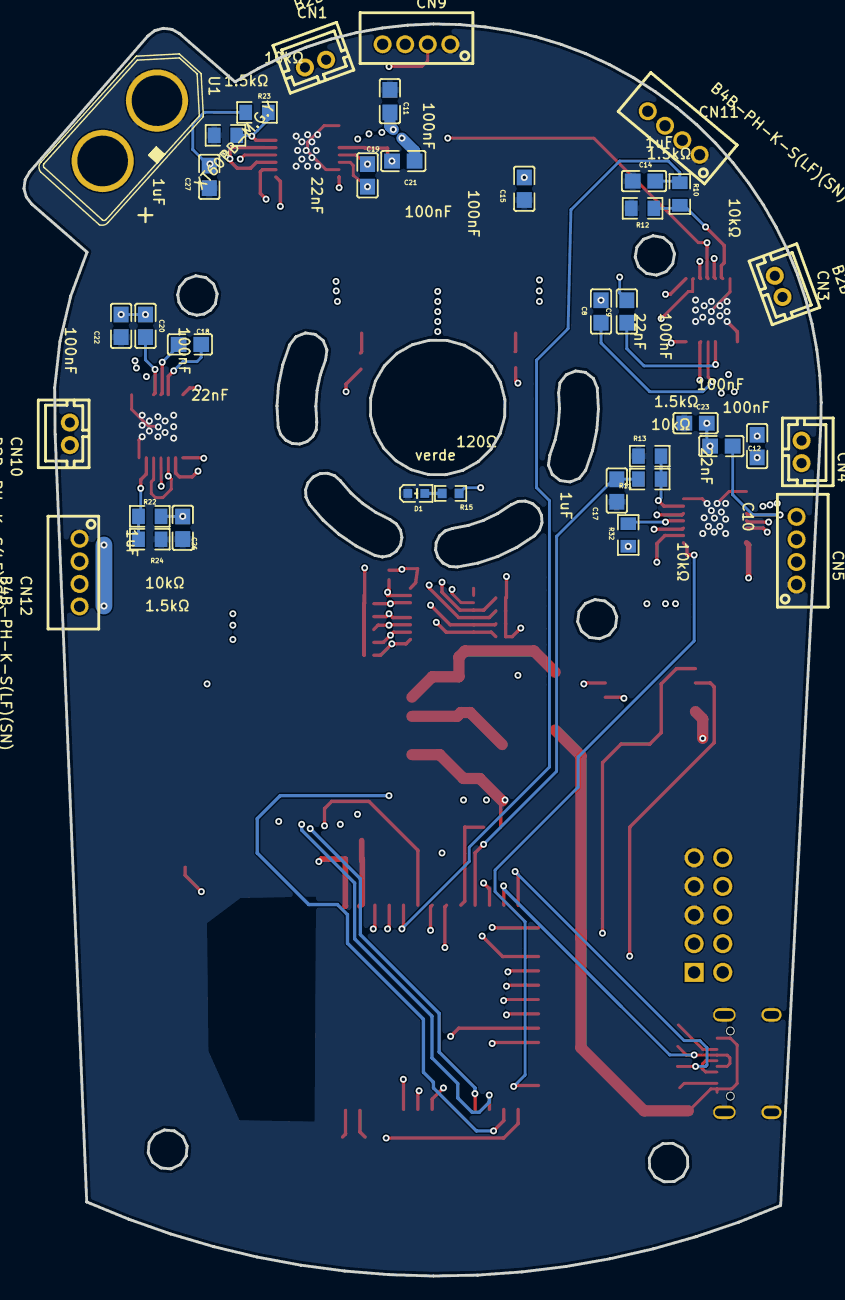
[picture p7: board Four Motor Control Board M5_fbc631ad57bc4ffbb8f9b332692f9e33.kicad_pcb from below]

Board: 4 copper layers, 70.7 x 111.0 mm, 82 parts (36 on the bottom side), 73 nets.

Parts:
C7, C13, C16, C24: 22uF; CAP-SMD_BD6.3-L6.6-W6.6-LS7.3-FD
C8, C10, C18, C19: 22nF; C0805
C9, C11, C12, C15, C20, C21, C22, C23: 100nF; C0805
C14, C17, C26, C27: 1uF; C0805
C29: 470uF; CAP-SMD_BD6.3-L6.6-W6.6-LS7.6-RD
C30: 100nF; C0603
C31: 10uF; C0805
C32, C33: 22pF; C0603
C34: 1uF; C0603
C40: 680uF; CAP-SMD_BD10.0-L10.3-W10.3-LS10.9-FD
CN1, CN3, CN4, CN10: B2B-PH-K-S(LF)(SN); CONN-TH_B2B-PH-K-S
CN5, CN9, CN11, CN12: B4B-PH-K-S(LF)(SN); CONN-TH_B4B-PH-K-S
D1: verde; LED0603-R-RD
D2, D3: SS14; SMA_L4.2-W2.6-LS5.3-RD
D5: RB050L-60TE25; SMA_L4.3-W2.7-LS5.1-RD
H1: 210S-2*5P L=11.6MMGold-plated black; HDR-TH_10P-P2.54-V-M-R2-C5-S2.54
L2: 33uH; IND-SMD_L6.0-W6.0
LED2: LED-0603_R; LED0603_RED
LED3: FC-DA1608BK-470H10; LED0603-RD
R1, R7, R12, R13, R24: 1.5kΩ; R0805
R2, R3, R15: 120Ω; R0603
R4, R9, R14: 5.1kΩ; R0805
R6, R8, R17, R18, R19, R20, R21, R25, R26, R27: 1kΩ; R0402
R10, R11, R22, R23, R32: 10kΩ; R0805
R28, R30: 10K; R0603
SW1: DTSL-61N-V-T/R; SW-SMD_4P-L6.2-W6.4-P4.00-LS7.2
U1: XT60PB-M.G.Y; CONN-TH_XT60PB-M
U2, U3, U5, U6: DRV8876PWPR; HTSSOP-16_L5.0-W4.4-P0.65-LS6.4-BL-EP
U7: TCA9546A; SOP-16_L5.0-W4.4-P0.65-LS6.4-BL
U9: ZDSD01GLGEAG; LGA-8_L6.0-W8.0-P1.27-BL
U10: ESP32-S3-WROOM-1
U16: LM2596R-3.3; TO-263-5_L10.2-W8.6-P1.70-LS14.4-TL
USB2: KH-TYPE-C-16P; USB-C-SMD_KH-TYPE-C-16P

Connections:
3V3: C29.1, C30.2, C31.2, CN5.4, CN9.4, CN11.4, CN12.4, L2.2, R6.2, R8.2, R15.2, R17.2, R18.2, R19.2, R20.2, R21.2, R25.2, R26.1, R27.2, R28.2, R30.2, R32.2, U2.3, U2.5, U2.16, U3.3, U3.5, U3.16, U5.3, U5.5, U5.16, U6.3, U6.5, U6.16, U7.3, U7.16, U9.8, U10.2, U16.4
ADCBL: C26.2, R22.1, U10.12
ADCBR: C27.2, R23.1, U10.7
ADCTL: C17.2, R11.1, U10.11
ADCTR: C14.2, R10.1, U10.6
AXISHEALTHLED: R3.2, U10.22
BLIN1: U5.1, U10.30
BLIN2: U5.2, U10.29
BLOUT1: CN10.2, U5.8
BLOUT2: CN10.1, U5.10
BOARDCOM1: H1.1, H1.3, U10.9
BOARDCOM2: H1.2, H1.4, U10.8
BOARDVERSION: R4.2, R30.1, U10.10
BOOT: SW1.2, U10.27
BRIN1: U6.1, U10.17
BRIN2: U6.2, U10.15
BROUT1: CN1.2, U6.8
BROUT2: CN1.1, U6.10
CLKV: U9.3, U10.20
D1_1: D1.1, R15.1
FAULT: R32.1, U2.4, U3.4, U5.4, U6.4, U10.33
GND: C7.2, C11.1, C13.2, C14.1, C15.1, C16.2, C17.1, C22.1, C23.1, C24.2, C26.1, C27.1, C29.2, C30.1, C31.1, C32.1, C33.1, C34.1, C40.2, CN5.1, CN9.1, CN11.1, CN12.1, D1.2, D5.2, H1.5, H1.7, H1.9, LED2.2, LED3.1, R1.1, R4.1, R9.1, R12.1, R13.1, R14.1, R24.1, SW1.4, U1.2, U2.7, U2.9, U2.15, U2.17, U3.7, U3.9, U3.15, U3.17, U5.7, U5.9, U5.15, U5.17, U6.7, U6.9, U6.15, U6.17, U7.1, U7.2, U7.8, U7.13, U9.4, U10.1, U10.40, U10.41, U16.3, U16.5, USB2.1, USB2.2, USB2.3, USB2.4, USB2.A1, USB2.A12, USB2.B1, USB2.B12
L2_1: D5.1, L2.1, U16.2
LED2_1: LED2.1, R3.1
LED3_2: LED3.2, R2.1
MCU_RST: C34.2, R28.1, U10.3
MISOV: U9.6, U10.21
MOSIV: U9.5, U10.19
SCL: R17.1, U7.14, U10.4
SCL0: CN9.2, R25.1, U7.5
SCL1: CN11.2, R26.2, U7.7
SCL2: CN5.2, R20.1, U7.10
SCL3: CN12.2, R18.1, U7.12
SDA: R8.1, U7.15, U10.5
SDA0: CN9.3, R6.1, U7.4
SDA1: CN11.3, R27.1, U7.6
SDA2: CN5.3, R21.1, U7.9
SDA3: CN12.3, R19.1, U7.11
SD_CS: U9.2, U10.18
TLIN1: U3.1, U10.26
TLIN2: U3.2, U10.23
TLOUT1: CN4.2, U3.8
TLOUT2: CN4.1, U3.10
TRIN1: U2.1, U10.35
TRIN2: U2.2, U10.34
TRINAMICRX: R7.1, U10.38
TRINAMICTX: R7.2, U10.39
TROUT1: CN3.2, U2.8
TROUT2: CN3.1, U2.10
U2_6: R10.2, R12.2, U2.6
U2_12: C9.2, U2.12
U2_13: C8.2, U2.13
U2_14: C8.1, U2.14
U3_6: R11.2, R13.2, U3.6
U3_12: C12.2, U3.12
U3_13: C10.2, U3.13
U3_14: C10.1, U3.14
U5_6: R22.2, R24.2, U5.6
U5_12: C20.2, U5.12
U5_13: C18.2, U5.13
U5_14: C18.1, U5.14
U6_6: R1.2, R23.2, U6.6
U6_12: C21.2, U6.12
U6_13: C19.2, U6.13
U6_14: C19.1, U6.14
U16_1: D2.1, D3.1, U16.1
USB2_A5: R9.2, USB2.A5
USB2_B5: R14.2, USB2.B5
USB5V: D3.2, USB2.A4, USB2.A9, USB2.B4, USB2.B9
USBD+: C32.2, U10.14, USB2.A6, USB2.B6
USBD-: C33.2, U10.13, USB2.A7, USB2.B7
VCC: C7.1, C9.1, C11.2, C12.1, C13.1, C15.2, C16.1, C20.1, C21.1, C22.2, C23.2, C24.1, C40.1, D2.2, H1.6, H1.8, H1.10, U1.1, U2.11, U3.11, U5.11, U6.11
WIFILED: R2.2, U10.28
