Moldudley/Maslow-Mini-Control-Board/(commit log)

2026-09-01 Add controller board
2026-09-01 First pass at merge
    [Maslow Mini Merged Board.kicad_sch, driver_section.kicad_sch, motor_control_section.kicad_sch]
2026-09-01 Do basic layout
    [Maslow Mini Merged Board.kicad_pcb]
